yuvalh10/Autonomous-IR-Guided-Competitive-Cart-with-Obstacle-Avoidance/Competitive Project - Report.pdf

המחלקה להנדסת
חשמל ואלקטרוניקה

## המחלקה להנדסת חשמל ואלקטרוניקה עגלה אוטונומית תחרותית

מוגש ע"י: יובל המר, 209158518 מוגש ע"י: רועי סביר, 318402484 מוגש ע"י: חי כספי, 213038060

מחלקה: הנדסת חשמל ואלקטרוניקה

בהנחיית: ד"ר פיני זורע

תאריך: 24/05/24

## תקציר:

בפרויקט זה נעסוק בתכנון ויישום של עגלה אוטונומית תחרותית, שביכולתה לקלוט אות אינפרה-אדום (IR (בתדר מסוים המשודר מקצהו השני של החדר. על העגלה לנוע בכיוון האות המשודר, ומטרתה להגיע למשדר בזמן הקצר ביותר.

מטרת הפרויקט זה הינה להתחרות בעגלות אוטונומיות אחרות, תוך התגברות על אתגרים שונים המגיעים ממספר גורמים והגעה ליעד בזמן הקצר ביותר.

את אות ה-IR ישלח מכלול שידור האות אשר ימוקם בקצה החדר. אות ה-IR מאופנן בפרוטוקול ידוע ומוגדר מראש. פרוטוקול זה נבחר מכיוון שהוא נבדל משאר אותות ה-IR הנמצאים באופן טבעי בחלל החדר )לדוגמה אותות המגיעים מנורות הלד שבחדר וכדומה(. אפנון זה מאפשר קליטה ופיענוח מהימנה ומדויקת יותר של האות המשודר. את הקליטה והפיענוח מבצע מכלול הקליטה של המערכת. מכלול זה מורכב ממקלטי ה-IR. מערכת זו מבצעת דגימה של המקלטים לאורך כל זמן העבודה של המערכת, ומשדר את המידע הנקלט והרלוונטי למכלול הבקרה ועיבוד נתונים - מכלול שיקבע איך העגלה תתקדם במסלול. בנוסף למכלולים אלו קיימים גם מכלול הנעת המערכת ומכלול התחמקות ממכשולים. מכלול ההנעה מורכב מ4- מנועי DC ובתוכו קיים מעגל הגברה אשר מספק את הכוח הנדרש להזנת המנועים )Driver).
מכלול ההתחמקות ממכשולים מורכב מרכיבים המודדים את מרחק העגלה מהמכשול שלפניה באופן רציף. הנתונים המתקבלים ממכלול זה נשלחים למכלול בקרה ועיבוד הנתונים והעגלה תתקן את נסיעתה בהתאם.
מכלול בקרה מעבד את המידע המתקבל משאר המכלולים לעיל ומחליט על אופן הפעולה.

תכנון הפרויקט כולל תכנון של סט בדיקות שונות עבור המכלולים השונים-שידור, קליטה, תיקון נסיעה והנעה. הבדיקות השונות כללו סט בדיקות פיזי ותוכנתי. לאחר תכנון וביצוע כל מכלול בנפרד, ותוך שיפור וייעול תמידי של כל אחד מהמכלולים, בוצעה אינטגרציה בין שאר המכלולים.

## תוכן עניינים

תקציר: 2 |
תרשים התחרות: 4 |
תיאור המערכת: 7 |
דרישות המערכת7 | :
מפרט פונקציונלי: 7 |
מפרט טכני8 | :
תרשים מלבנים9 | :
חומרה9 | :
תוכנה10 | :
פירוט מכלולים ותכנון המעגל: 11 |
מכלול שידור IR: 11 |
מכלול קליטה IR12 | :
מכלול עיבוד נתונים13 | :
מכלול הנעה ותזוזה: 14 |
מכלול זיהוי והתחמקות ממכשולים: 15 |
מטלות הנדסיות: 16 |
תיאור המטלות: 16 |
אתגרים הנדסיים16 | :
עמידה בדרישות17 | :
כלי פיתוח17 | :
ביבליוגרפיה וסימוכין17 | :

רשימת קיצורים ומונחים

IR Infrared, תת – אדומ/ה

## תרשים התחרות:

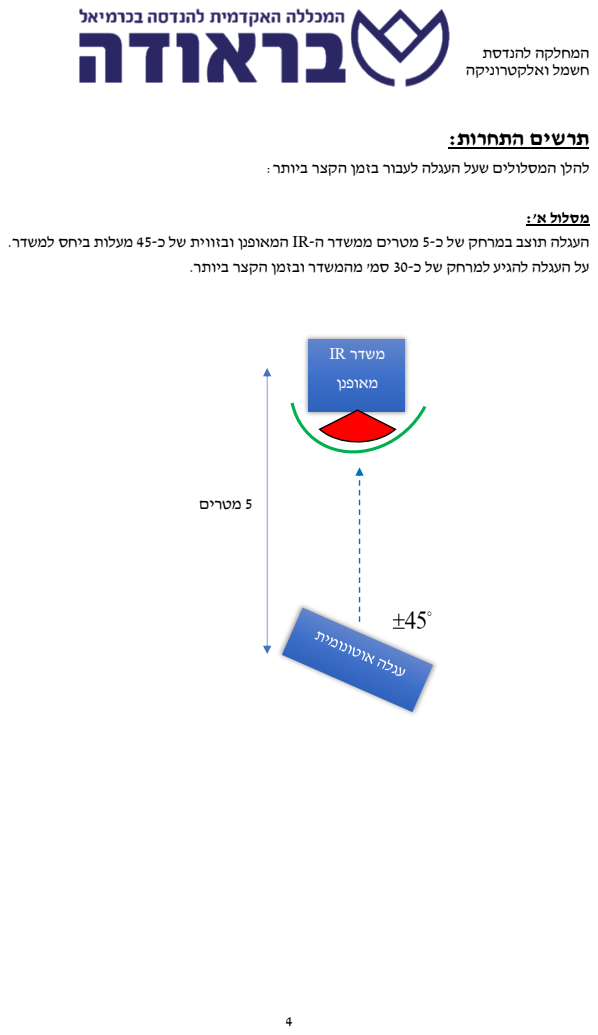
[picture p1: page 4]
מסלול א':; משדר IR; מאופנן; 5 מטרים

להלן המסלולים שעל העגלה לעבור בזמן הקצר ביותר:

העגלה תוצב במרחק של כ5- מטרים ממשדר ה-IR המאופנן ובזווית של כ45- מעלות ביחס למשדר.

על העגלה להגיע למרחק של כ30- סמ' מהמשדר ובזמן הקצר ביותר.

מסלול ב':
העגלה תוצב במרחק של כ5- מטרים ממשדר ה-IR המאופנן כשבניהם יוצבו שני מכשולים שהעגלה תצטרך לעבור במטרה להגיע למרחק של כ30- סמ' מהמשדר ובזמן הקצר ביותר.

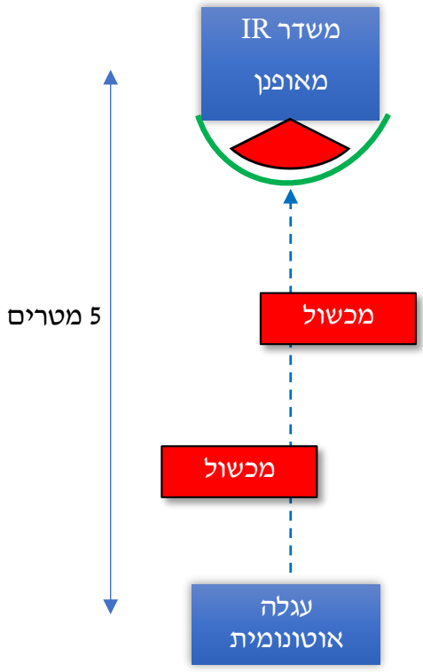
[picture p2: figure]
5 מטרים; מכשול; עגלה אוטונומית; משדר IR; מאופנן

במידה והעגלה עברה בהצלחה את מסלולים א' ו-ב' בזמנים הקצרים ביותר, תעבור העגלה למסלול ג'.

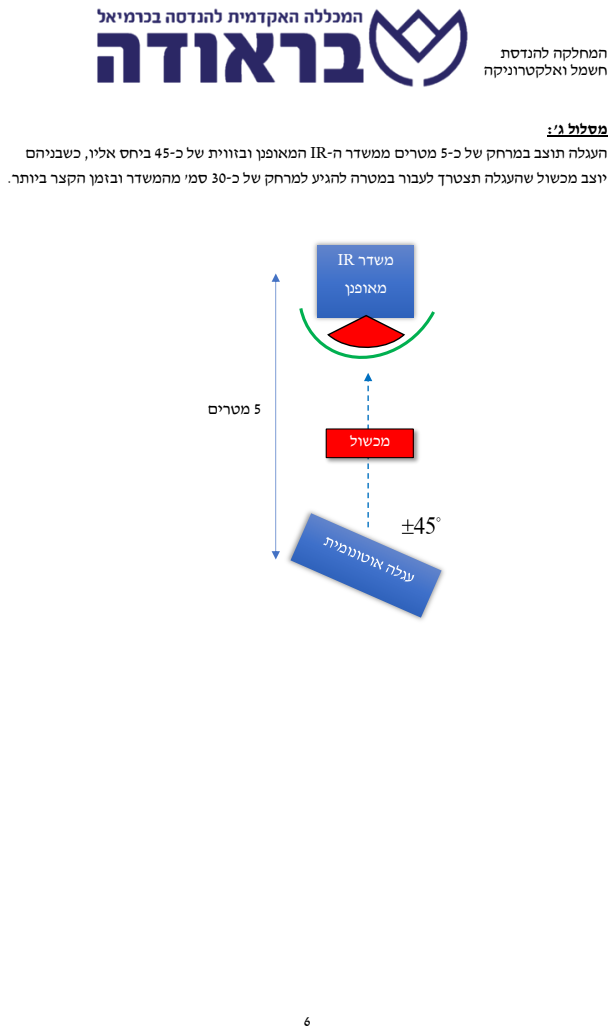
[picture p3: page 6]
מסלול ג':; משדר IR; מאופנן; 5 מטרים; מכשול

העגלה תוצב במרחק של כ5- מטרים ממשדר ה-IR המאופנן ובזווית של כ45- ביחס אליו, כשבניהם
יוצב מכשול שהעגלה תצטרך לעבור במטרה להגיע למרחק של כ30- סמ' מהמשדר ובזמן הקצר ביותר.

## תיאור המערכת :

דרישות המערכת:

- על העגלה להיות אוטונומית לחלוטין, ללא התערבות חיצונית של המשתמש, פרט להתחלת המסלול ובסופו.
- העגלה תבצע את פעולתה במשטחים מישוריים, חלקים וללא הפרשי גובה.
- העגלה תתחמק ממכשולים נייחים בסדר גודל של קופסת נעליים גדולה.
- העגלה תדע להתעלם מתשדורות בתדרים שונים, פרט לתדר ה-IR הייחודי לעגלה זו.
- הפעלתה ועצירתה של העגלה תיעשה בעזרת תקשורת בלוטות'.
- המערכת תבצע את פעולתה במסלול שאורכו כחמישה מטרים.

מפרט פונקציונלי:
יכולות העגלה האוטונומית:
- מציאת מקור השידור IR בתדר מוגדר מראש, תוך התעלמות מתדרים אחרים המתבססים גם הם על תשדורת IR.
- תחילת תנועה לכיוון המשדר ברגע שזוהה, תוך תיקון כיוון הנסיעה במידת הצורך.
- נסיעה קדימה, ימינה ושמאלה.
- זיהוי מכשולים ויכולת התחמקות מהם.

יכולות משדר:
- קידוד התשדורת IR בתדר kHz 38 המותאם למקלט בעגלה האוטונומית.

מפרט טכני:

| | מכלולי המערכת תפקיד מפרט
Arduino Mega 2560 | עיבוד המידע המתקבל מהחיישנים השונים וקבלת החלטות בהתאם לנתונים. | מכלול בקרה ועיבוד נתונים
L293 Motor Driver HC-06 DC Gear Motor TT ➢ 130 RPM ➢ 3 – 6 Volt | תזוזת המכונית אל עבר המשדר במהירות הגבוהה ביותר. | מכלול הנעה ותזוזה
UltraSonic SRF-04 ➢ Operating Voltage: 5 [V] ➢ - Min & Max Range: 3 ]cm], 3 [m] ➢ - Frequency: 40 [kHz] | זיהוי עצמים נייחים ומדידת מרחק העגלה מהעצמים. | מכלול זיהוי והתחמקות ממכשולים
Arduino Nano IR333-A ➢ frequency: 38 [kHz] ➢ Operating voltage: 5 | משדר לשידור קרן IR המכתיב את כיוון נסיעת העגלה. | מכלול שידור IR
TSOP4838 ➢ frequency: 38 [kHz] ➢ Operating voltage: 2.5-5.5 [V] | מקלטים לקליטת קרן ה-IR הייחודית, ימוקמו בחזית העגלה. | מכלול קליטת השידור IR

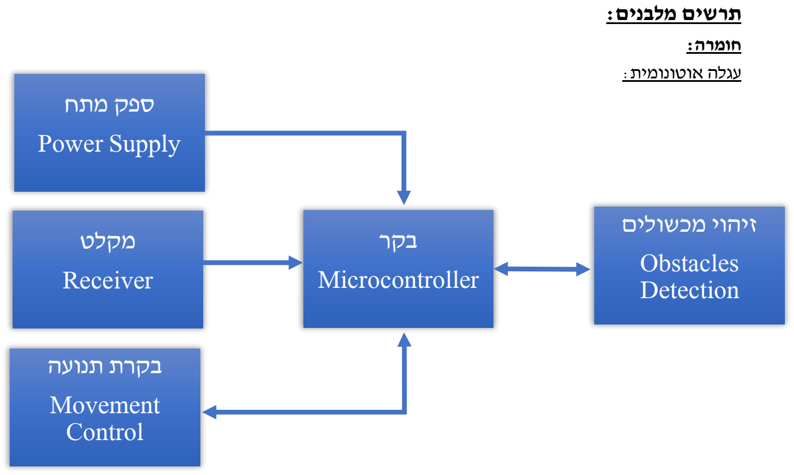
[picture p4: figure]
תרשים מלבנים:; חומרה: עגלה אוטונומית:; בקר; Microcontroller; ספק מתח; Power Supply; מקלט; Receiver; זיהוי מכשולים; Obstacles Detection; בקרת תנועה; Movement Control

מכלול שידור IR:

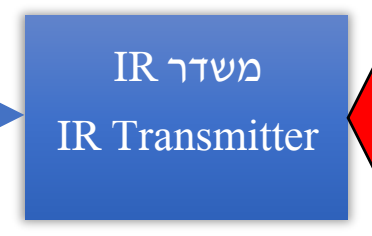
[picture p5: figure]
משדר IR; IR Transmitter
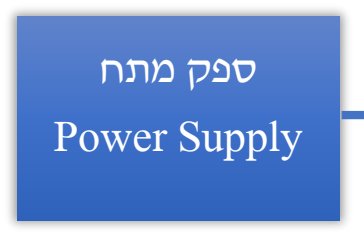
[picture p6: figure]
ספק מתח; Power Supply
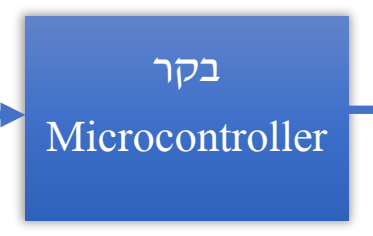
[picture p7: figure]
בקר; Microcontroller
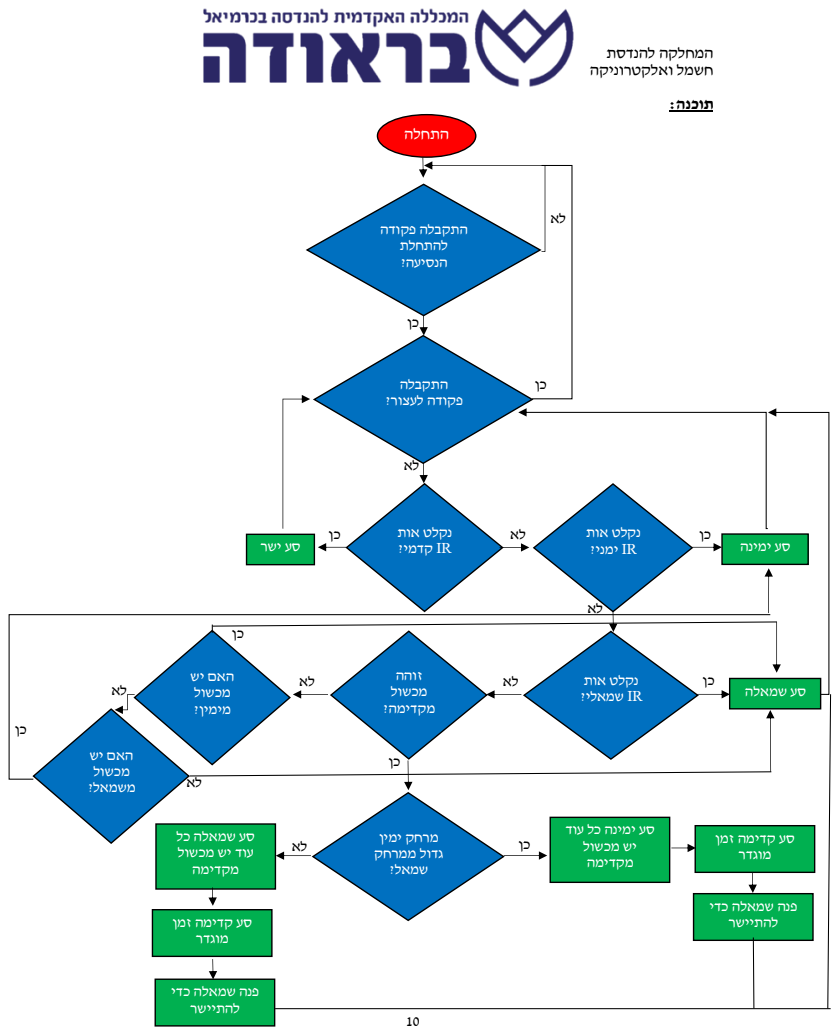
[picture p8: page 10]
תוכנה:; התחלה; התקבלה פקודה לעצור?; האם יש מכשול מימין?; סע ישר; התקבלה פקודה להתחלת הנסיעה?; נקלט אות IR קדמי?; זוהה מכשול מקדימה?; האם יש מכשול משמאל?; מרחק ימין גדול ממרחק שמאל?

נקלט אות
סע ימינה IR ימני?

סע שמאלה IR שמאלי?

סע ימינה כל עוד
יש מכשול
מקדימה

סע שמאלה כל
עוד יש מכשול

סע קדימה זמן
מוגדר

פנה שמאלה כדי
להתיישר

## פירוט מכלולים ותכנון המעגל:

מכלול שידור IR:
מכלול זה מספק לעגלה האוטונומית אות IR בתדר שהוחלט מראש. בסביבת העבודה שבה נבדקה העגלה האוטונומית קיימים אותות IR שונים הנובעים בין היתר ממנורות, גוף האדם וכו', דבר אשר שיכול להפריע לקליטת אות ה-IR הרצוי שלנו, לכן הוחלט על תדר של Hz 185 אשר שונה מהתדרים האלקטרו-מגנטיים בסביבה.
במטרה להעביר את התדר הנבחר בתווך, איפננו אותו בתדר KHz .38 רכיבי מכלול השידור:
Arduino Nano
IR-333A Led

Resistors

(5 1 Ω, kΩ)

N4401 NPN Transistor
External Power Source 5 V
אפנון האות מתבצע על ידי בקר הארדואינו. הבקר שולח סדרה של דפקים בתדר של KHz .38 לרגל של הבקר מחובר טרנזיסטור המשמש כמתג וגורם ל – Led להבהב בתדר המבוקש. להלן תרשים מכלול השידור IR:

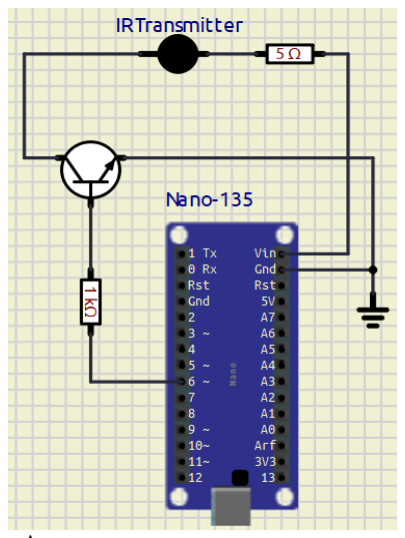
[picture p9: figure]

לפי דף הנתונים של הרכיב A-333IR, זרם העבודה המתמשך הוא mA 100 והזרם המקסימאלי הרגעי הוא A .1 כמו כן, במהלך תכנון מכלול זה היה צורך להתחשב בפיזור הזוויתי של קרן ה-IR בה נשתמש.
פיזור הקרן באופן המתואר בשרטוט בתוך חלל סגור, עלול לגרום לשגיאות בזיהוי השידור על ידי מכלול הקליטה.

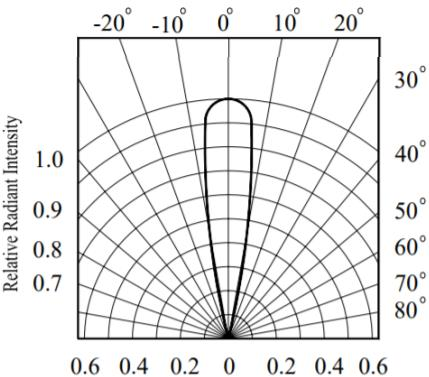
[picture p10: figure]

מכלול קליטה IR:
המכלול מספק לעגלה האוטונומית יכולת לזהות את אות ה-IR מהמשדר ולידע את מכלול הבקרה ועיבוד הנתונים על זיהוי האות. החומרה שבשימוש במכלול:
3 מקלטים מסוג 4838TSOP – IR המחוברים לבקר הארדואינו MEGA. כמו כן, במכלול זה הוחלט ליישם מגביל תדר ב כתיבת התוכנה במטרה למנוע קליטה של אותות אלקטרו-מגנטיים לא רצויים מהסביבה. להלן שרטוט של מעגל קליטת אות IR:

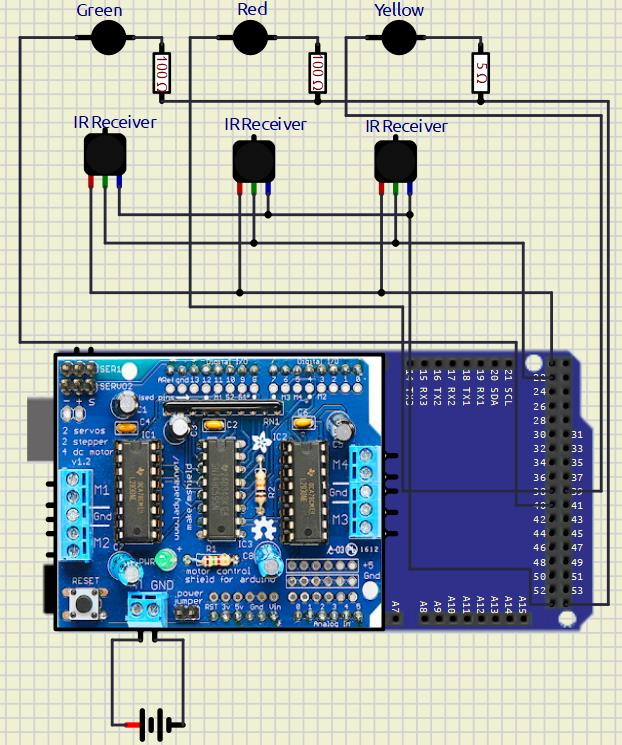
[picture p11: figure]

נציין כי במהלך בדיקת המכלול ראינו כי הייתה קליטה מרובה של האות הרצוי מהחזרים במעבדה. פתרון שהוחלט ליישם הוא הוספת צינור אטום בקוטר קטן )קש( הממקד את טווח הקליטה של האות.

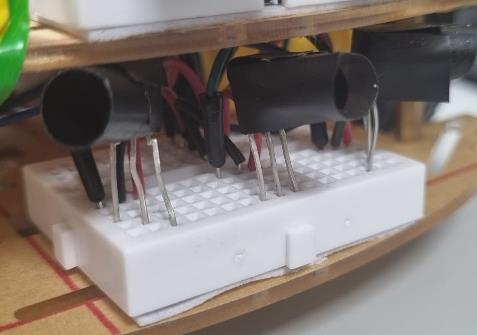
[picture p12: figure]

בנוסף, לכל משדר חוברה נורת LED בצבעים שונים על מנת להיות בבקרה איזה משדר קולט את האות המשודר בזמן נסיעת העגלה.

מכלול עיבוד נתונים:
מטרת מכלול זה הינה איסוף כלל המידע והנתונים השונים המגיעים מכל המכלולים והחיישנים בעגלה ולקבל החלטות לגבי הפעולה הבאה שעל העגלה לבצע, במטרה להגיע לקו הסיום. החומרה שבשימוש במכלול:
.Mega Arduino בקר

על מנת לחסוך בחומרה ובמטרה לפשט את המעגל, השתמשנו בבקר יחיד לעיבוד הנתונים, דבר אשר גרם לביצועים טובים יותר.

מכלול הנעה ותזוזה:
מכלול זה אחראי לגרום לתזוזת העגלה מנקודה אחת אל המטרה, במהירויות שונות, בהתאם לצורך. על מנת שהעגלה תתחיל את פעולתה, נשתמש ברכיב -06HC שדרכו ניתן להתחבר עם תקשורת בלוטות'. כאשר זוהה חיבור, העגלה תתחיל את פעולתה. העגלה תחדל מלנוע כאשר תתנתק תקשורת הבלוטות'.
כמו כן, נבחרו מנועי DC מסוג -130TT ו- מעגל D293L) Driver (אשר הורכב על גבי הבק ר -Arduino Mega וה-Driver מתנהג כדוחף זרם למנועים וכך מספק זרם מספק להפעלת המנועים בטווח המהירויות לפי דרישותינו מהעגלה. רכיבי המכלול:
HC-06
TT-130-Gear DC motor | מסוג | מנועים | 4
Arduino Mega | הבקר | על | המתלבש | ) Driver) L293D | מעגל

ארבעת המנועים מחוברים ע"י קווי VCC ו -GND למתחי האספקה והאדמה של ה-Driver. מכיוון שהמנוע הוא צרכן זרם גדול והעגלה משתמשת ב4-מהם אשר צריכים לעבוד במקביל ובפרקי זמן ארוכים יחסית, אין ביכולתו של הבקר לספק את הזרם הדרוש לצורך הפעלתם. לשם כך השתמשנו ב-Driver אשר עונה על דרישותינו.
ה-Driver מחובר למקור מתח חיצוני )4 סוללות ליתיום, V 3.5 כ"א(
ה-Driver מחובר ע"י פינים לבקר, ובעזרתו שולטים בהפעלת המנועים.
נציין כי תנועת העגלה תלויה במצבים שונים בהתאם לנתונים המגיעים לבקר מהחיישנים והמכלולים השונים במערכת.

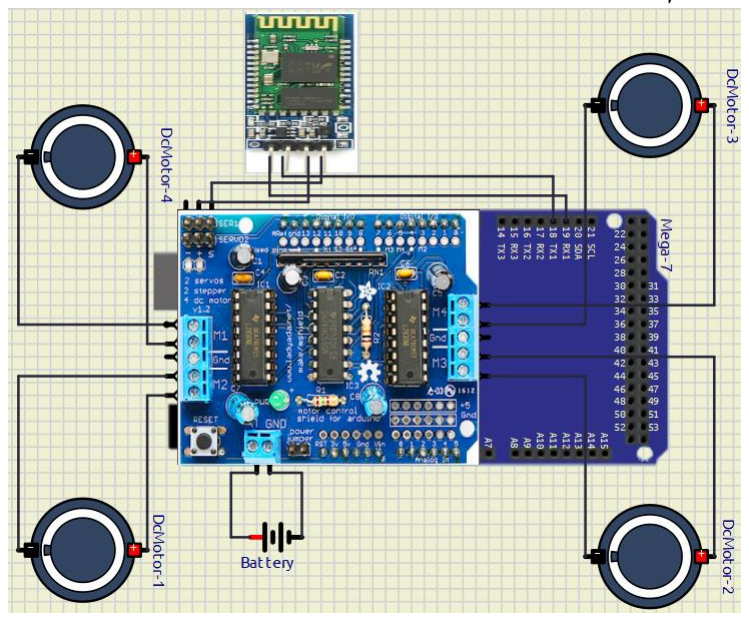
[picture p13: figure]

את מצבי הנסיעה חילקנו לפונקציות ייעודיות כאשר כל פונקציה אחראית לכיוון התקדמות העגלה, ומספק כוח למנועים בהתאם. להלן תיאור מצבי הנסיעה של העגלה: כיוון עבודת המנועים
M4 | M3 | M2 | M1 | התקדמות כיוון
BACKWARDS | BACKWARDS | BACKWARDS | BACKWARDS | אחורה
FORWARD | FORWARD | FORWARD | FORWARD | קדימה
BACKWARDS | BACKWARDS | FORWARD | FORWARD | ימינה
FORWARD | FORWARD | BACKWARDS | BACKWARDS | שמאלה

מכלול זיהוי והתחמקות ממכשולים:
מכלול זה אחראי לספק למערכת יכולת לזהות עצמים ומכשולים במרחקים שונים. ע"י עיבוד הנתונים העגלה יכולה לפנות לכיוונים שונים בהתאם להצבת המכשול ולהתחמק ממנו. רכיבי המכלול:
UltraSonic SRF-04 | חיישנים | 3
החיישן בנוי ממשדר ומקלט דפקים חשמליים. המשדר בחיישן משדר אות אולטרה-סאונד בתדר של KHz 40 לחלל החדר. האות פוגע במכשול הנמצא מול החיישן ומחזיר את האות למקלט. החיישן ייכנס לפעולה לאחר שהתקיימו התנאים הבאים: .1 אות ה-Trigger יקבל פולס ברוחב של μ .10 .2 לאחר מכן החיישן ישדר 8 דפקים אולטרה סוניים רצופים וייכנס למצב קליטה ויעלה את ה-.Echo
.3 במצב הקליטה, החיישן ימתין לחזרת האות ששידר ויתזמן את חזרתו.

להלן דיאגרמה הממחישה את אופן פעולת החיישן:

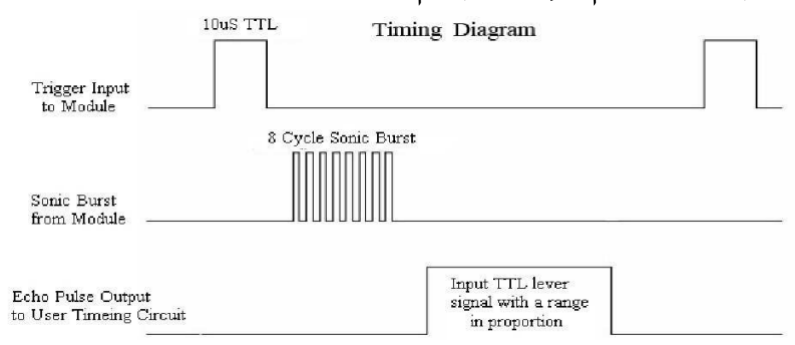
[picture p14: figure]
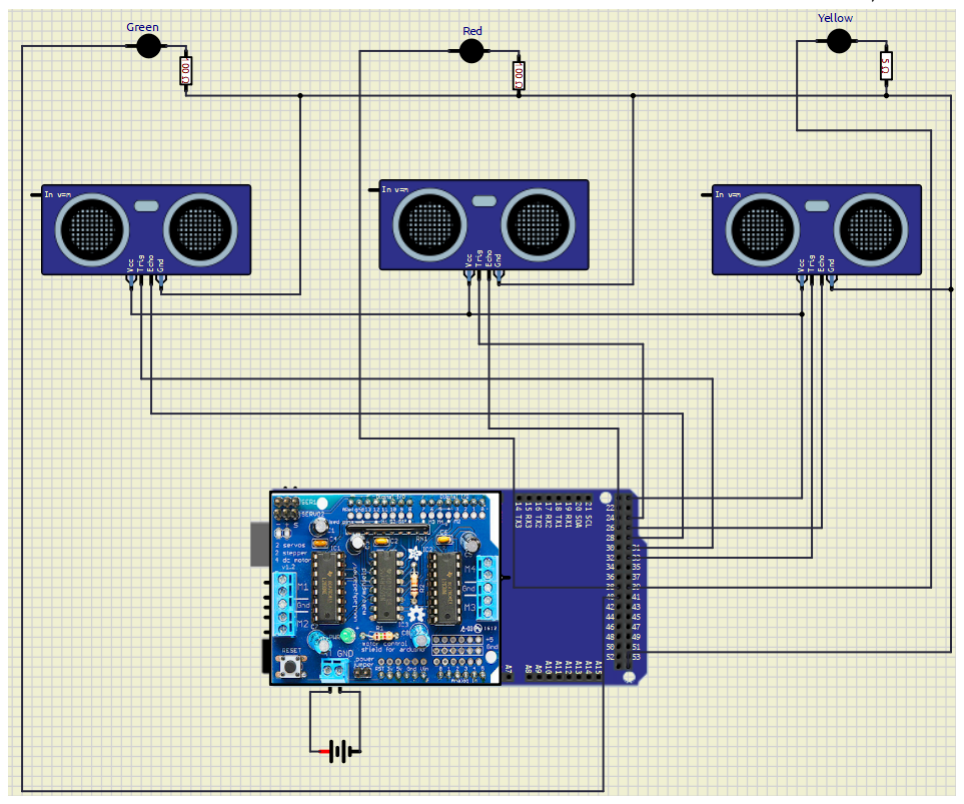
[picture p15: figure]

מכלול זה עובד באופן רציף ומודד את המרחק למכשול הקרוב ביותר שיכול להעיד על הגעת העגלה לעצם שעליה להתחמק ממנו.
המרחק המינימלי הנדרש לתפעול המעגל ולהימנע מפגיעה בעצם שכזה נקבע על ידי בדיקות וניסויים בעת בניית מכלול זה )זיהוי מכשולים מ75-סנטימטרים(.

להלן שרטוט של מעגל זיהוי והתחמקות ממכשולים:

כמו כן, למען בקרה, הנורות בתרשים זה מסמנות את כיוון התנועה של העגלה, במידה וזוהה מכשול לפניה.

## מטלות הנדסיות :

תיאור המטלות:
.1 כתיבת הצעת פרויקט.
.2 כתיבת ספר פרויקט.
.3 תכנון מכלול שידור וקליטת IR למרחק של חמישה מטרים לפחות. .4 כתיבת אלגוריתם לנסיעה אוטונומית תוך הימנעות ממכשולים. .5 הכרות וכתיבת קוד עם Arduino IDE וספריות הנלוות אליה. .6 בדיקות חומרה ותוכנה למערכת לאיתור תקלות. .7 שיפור המערכת מבחינת זמנים ודיוק הפעולה. .8 אינטגרציית כלל המערכות שצוינו.

אתגרים הנדסיים:
.1 אמינות חיישנים אולטרה סוניים – אם הזווית בין החיישנים למכשול גדולה מידי החיישן לא קולט את גל ההחזר. כתוצאה מכך מתקבל מידע שגוי על שטח פתוח. התגברנו על בעיה זו כאשר הצבנו את החיישנים בזווית כמעט מאונכת לכיוון ההתקדמות של העגלה. .2 זווית השידור של משדר IR – זווית השידור של המשדר רחבה מידי למטרת הפרויקט שלנו מה שגרם לקליטה מכיוונים לא רצויים במקלטי ה-IR. כתוצאה מכך העגלה לעיתים נסעה לכיוונים שגויים. פתרנו את בעיה זו בכך שהצבנו קשים על מקלטי ה-IR ובכך הצרנו את טווח הקליטה שלהם למצב שבו הם קולטים רק כשהם מול המשדר. .3 חיישני ה-IR רגישים לקליטה, לכן היה צורך להתחשב בכך באלגוריתם הצרוב על הבקר. כמו כן, במידה והייתה תשדורת IR נוספת, טיב הקליטה ירד באופן משמעותי. .4 ביצועי העגלה היו איטיים מידי לטעמנו. על מנת להתגבר על בעיה זו חיברנו את ה- Driver למקור מתח חיצוני של 4 סוללות )14.5 וולט( כדי לתת יותר כוח למנועים.

עמידה בדרישות:

מטלה סטטוס ביצוע
| 1 מציאת קרן ה-IR ממקום הימצאותה של העגלה. בוצע
| 2 יכולת קליטת הקרן ממרחק של 5 מטרים לפחות בוצע
| 3 התעלמות מקרני IR בתדרים השונים מהתדר שהוגדר לקליטה. בוצע
| 4 התבייתות על הקרן ה-IR ונסיעה לכיוונה. בוצע
| 5 תיקון אוטונומי של הנסיעה בעת איבוד קרן השידור. בוצע
| 6 התחמקות ממכשולים בעת שזוהו במהלך הנסיעה. בוצע
| 7 התבייתות על הקרן ה-IR ונסיעה לכיוונה. בוצע
| 8 תיקון אוטונומי של הנסיעה בעת איבוד קרן השידור. בוצע
| 9 עצירתה והפעלתה של העגלה באמצעות תקשורת בלוטוס. בוצע

## כלי פיתוח:

IDE Arduino

SimulIDE

## ביבליוגרפיה וסימוכין:

Autonomous Cart - Code (https://1drv.ms/u/s!AnQ2VsqUAy-Qhq0KotrLDz7YMw2bsg?e=4K6BRf)
IR Transmission - Code (https://1drv.ms/u/s!AnQ2VsqUAy-QhrYDZlSBegfaYvjP6Q?e=QOzU00)
Demonstration Course A (https://1drv.ms/v/s!AnQ2VsqUAy-Qhq80deULo7Q3MGYktA?e=peAqXo)
Demonstration Course B (https://1drv.ms/v/s!AnQ2VsqUAy-Qhq8ytElhlSCek7ZM4g?e=9fEwIf)
Demonstration Course C (https://1drv.ms/v/s!AnQ2VsqUAy-Qhq8zscYKH0u2vmyCIQ?e=6KDgrb)
Arduino Mega 2560 (https://docs.arduino.cc/resources/datasheets/A000067-datasheet.pdf)
L293 Motor Driver (http://www.ti.com/lit/ds/symlink/l293.pdf)
DC Gear Motor TT (https://media.digikey.com/pdf/Data%20Sheets/Adafruit%20PDFs/3777_Web.pdf)
HC-06 (https://www.olimex.com/Products/Components/RF/BLUETOOTH-SERIAL-HC-06/resources/hc06.pdf)
UltraSonic SRF-04 (https://cdn.sparkfun.com/datasheets/Sensors/Proximity/HCSR04.pdf)
Arduino Nano (https://docs.arduino.cc/resources/datasheets/A000005-datasheet.pdf)
IR333-A (https://docs.particle.io/assets/datasheets/makerkit/ir333-a.pdf)
TSOP4838 (https://www.vishay.com/docs/82459/tsop48.pdf)
